warmwaffles/scalenode/(commit log)

2021-03-30 Add two M2.5 mounting holes near J2 connector
    [compute-module.sch, expansion-connectors.sch, interfaces.sch, nvme-ssd.sch, poe.sch, scalenode.kicad_pcb, scalenode.sch, supply.sch]
2021-04-06 Add UART converter (console) and flashing mode jumper to schematic
    [compute-module.sch, expansion-connectors.sch, interfaces.sch, nvme-ssd.sch, poe.sch, scalenode.kicad_pcb, scalenode.sch, supply.sch]
2021-04-08 Add board photo
